blonestar/raspberry-pi-meanwell-case/cad/logos/README.md

# Logos

| File | What | Source |
|---|---|---|
| `raspberry-pi.svg` | Raspberry Pi logo, one colour | [Simple Icons 11.0.0](https://cdn.jsdelivr.net/npm/simple-icons@11.0.0/icons/raspberrypi.svg), which takes it from the [Raspberry Pi trademark rules](https://www.raspberrypi.org/trademark-rules) |

The Home Assistant logo is drawn directly in the design (sketches `HA_logo` and `HA_logo_cvorovi`).

Both logos are trademarks of their owners: Raspberry Pi Ltd and the Open Home Foundation. The Simple Icons collection is CC0, but that does not cover the trademarks. Read each owner's rules before you sell prints with a logo on them.
