blonestar/raspberry-pi-meanwell-case/images/fan-clips.png

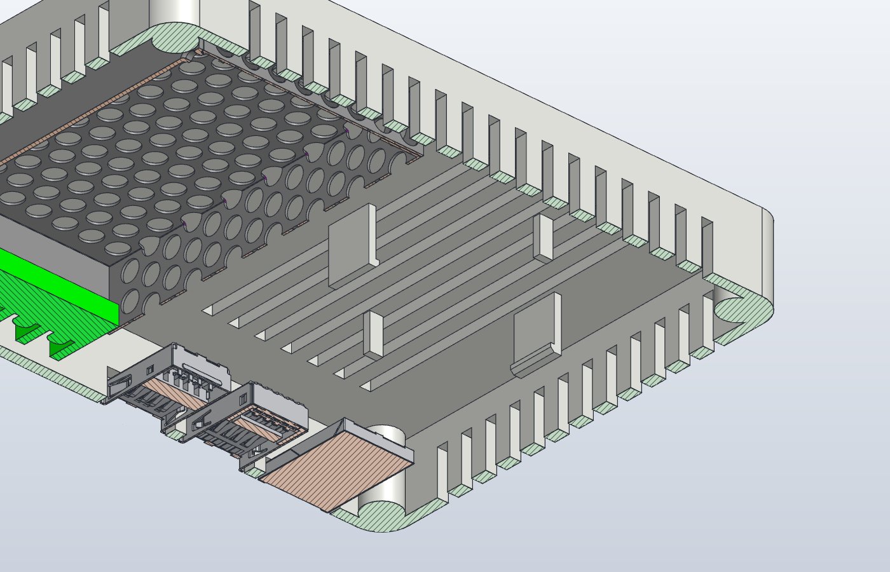
images/fan-clips.png
