blonestar/raspberry-pi-meanwell-case/step/base.step

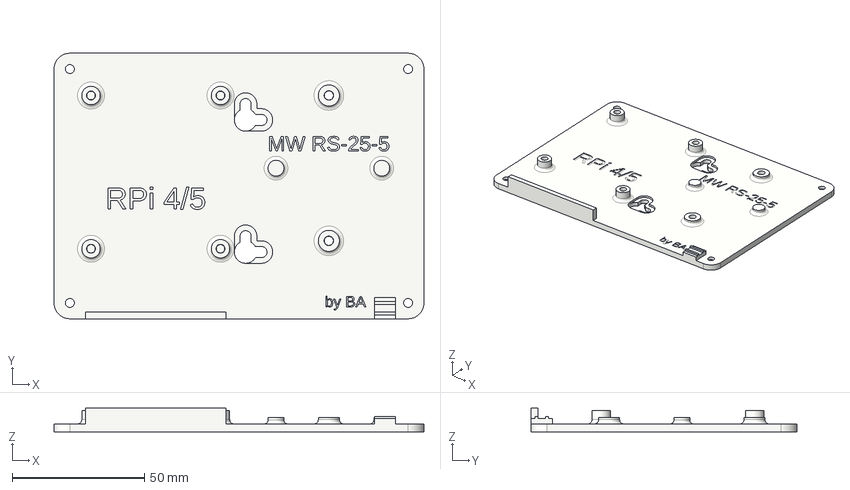
[picture p6: CAD file, 2026-11-13]
step/base.step
140.0 x 100.5 x 8.98 mm
