blonestar/raspberry-pi-meanwell-case/step/lid_rpi5_ha_fan40.step

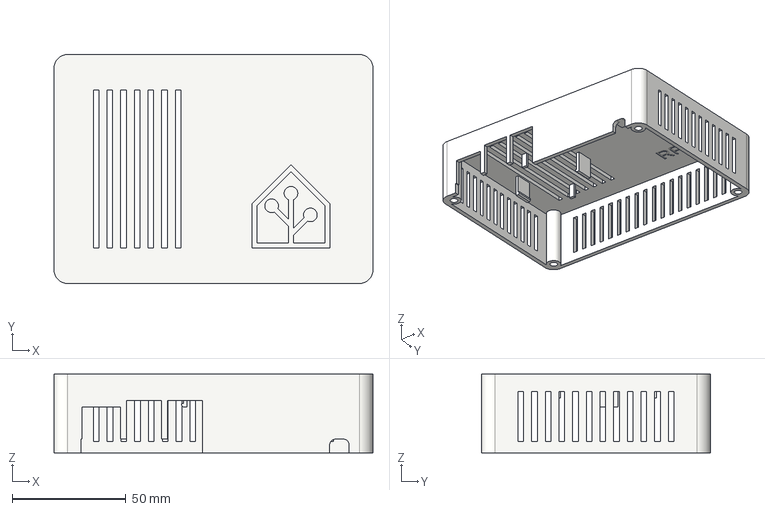
[picture p7: CAD file, 2026-11-13]
step/lid_rpi5_ha_fan40.step
140.0 x 100.5 x 34.5 mm
