blonestar/raspberry-pi-meanwell-case/(list of files, cad)

Other CAD files:
step/lid_rpi5_plain.step
step/lid_rpi4_plain.step
step/lid_rpi4_ha_fan40.step
step/lid_rpi5_plain_fan30.step
step/lid_rpi4_plain_fan30.step
step/lid_rpi5_ha.step
step/lid_rpi4_raspberry.step
step/lid_rpi4_raspberry_fan30.step
step/lid_rpi5_raspberry_fan40.step
step/lid_rpi4_ha_fan30.step
step/lid_rpi5_raspberry_fan30.step
step/lid_rpi4_raspberry_fan40.step
step/lid_rpi5_raspberry.step
step/lid_rpi4_ha.step
step/lid_rpi5_ha_fan30.step
step/lid_rpi4_plain_fan40.step
step/lid_rpi5_plain_fan40.step
stl/base.stl
stl/lid_rpi4_ha.stl
stl/lid_rpi4_ha_fan30.stl
stl/lid_rpi4_ha_fan40.stl
stl/lid_rpi4_plain.stl
stl/lid_rpi4_plain_fan30.stl
stl/lid_rpi4_plain_fan40.stl
stl/lid_rpi4_raspberry.stl
stl/lid_rpi4_raspberry_fan30.stl
stl/lid_rpi4_raspberry_fan40.stl
stl/lid_rpi5_ha.stl
stl/lid_rpi5_ha_fan30.stl
stl/lid_rpi5_ha_fan40.stl
stl/lid_rpi5_plain.stl
stl/lid_rpi5_plain_fan30.stl
stl/lid_rpi5_plain_fan40.stl
stl/lid_rpi5_raspberry.stl
stl/lid_rpi5_raspberry_fan30.stl
stl/lid_rpi5_raspberry_fan40.stl
