blonestar/raspberry-pi-meanwell-case/(commit log)

2026-11-13 Raspberry Pi 4/5 + Mean Well RS-25-5 enclosure
    Parametric SolidCraft design with one base for both boards and 18 lid
    variants (board x logo x fan), exported to STL (print orientation) and
    STEP by scripts/export_variants.py. Docs cover BOM, printing, assembly
    and editing the design.
    [base.step, base.stl, lid_rpi4_ha.step, lid_rpi4_ha.stl, lid_rpi4_ha_fan30.step, lid_rpi4_ha_fan30.stl, lid_rpi4_ha_fan40.step, lid_rpi4_ha_fan40.stl]
2026-11-13 Document GPIO power, fasteners and CC BY-NC-SA 4.0 license
    Power goes from the RS-25-5 to GPIO pins 2/4 (5 V) and 6/14 (GND); the
    fan moves to the PSU terminals or the Pi 5 fan header. Screws are
    M3x8 ISO 10642 for lid and PSU (M3x6 would enter the PSU only 0.5 mm)
    and M2.5x6 ISO 4762 for the Pi.
2026-11-13 Add cad/SOLIDCRAFT.txt with SolidCraft version and download links
    Also fix the SolidCraft link in docs/customizing.md, which pointed to a
    domain that does not resolve.
2026-11-13 Record SolidCraft version and file format, check them on every PR
    cad/SOLIDCRAFT.txt now says the design was made with SolidCraft 0.41.0
    in file format solidcraft/55. The .sc file stores only the format, so
    scripts/check_cad_info.py compares that and fails when a newer SolidCraft
    changed it without SOLIDCRAFT.txt being updated.
